alphaLeporis/velostat_development_kit/images/DSCF1139.jpg

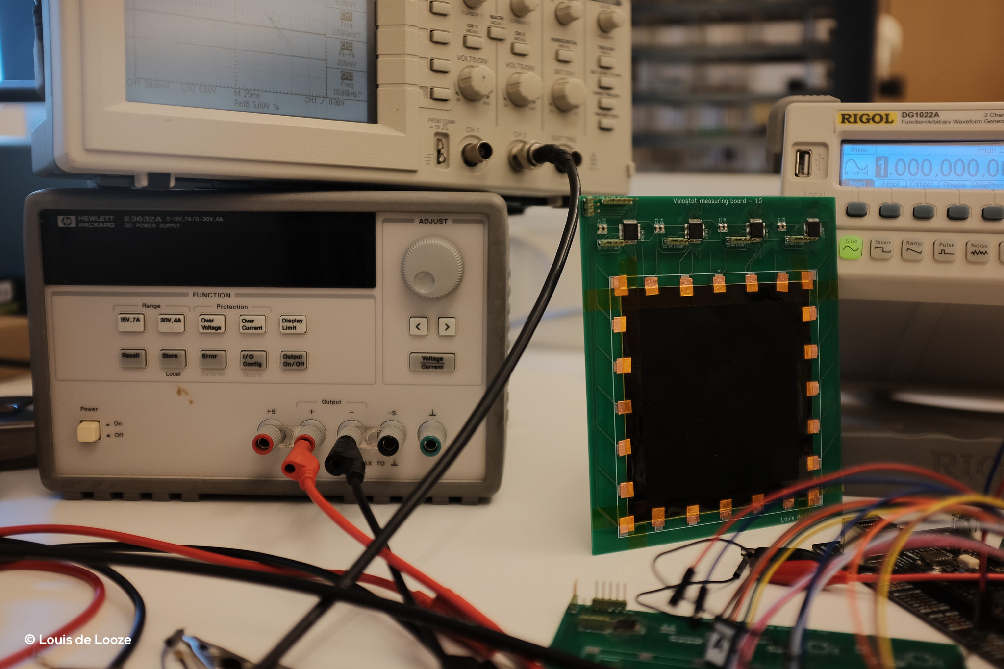
images/DSCF1139.jpg
