alphaLeporis/velostat_development_kit/images/DSCF1140.jpg

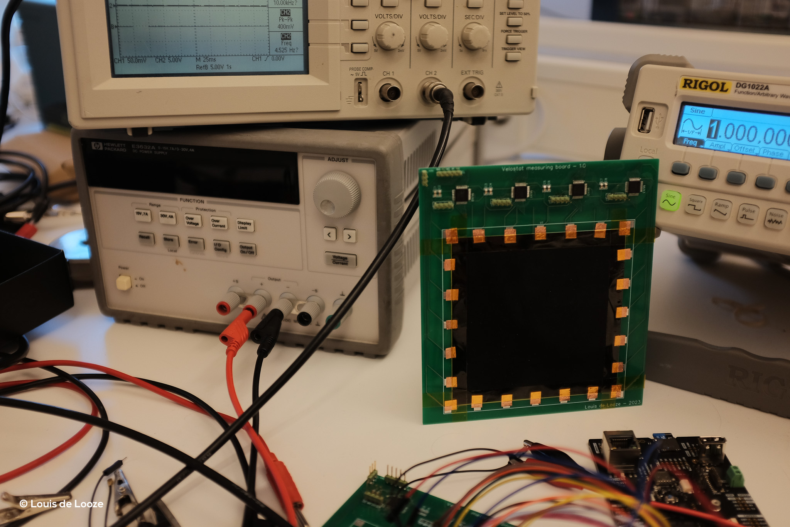
images/DSCF1140.jpg
