alphaLeporis/velostat_development_kit/images/DSCF1132.jpg

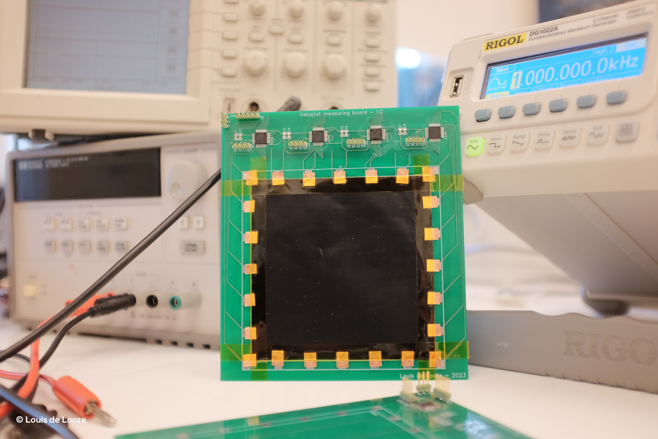
images/DSCF1132.jpg
