alphaLeporis/velostat_development_kit/images/DSCF1133.jpg

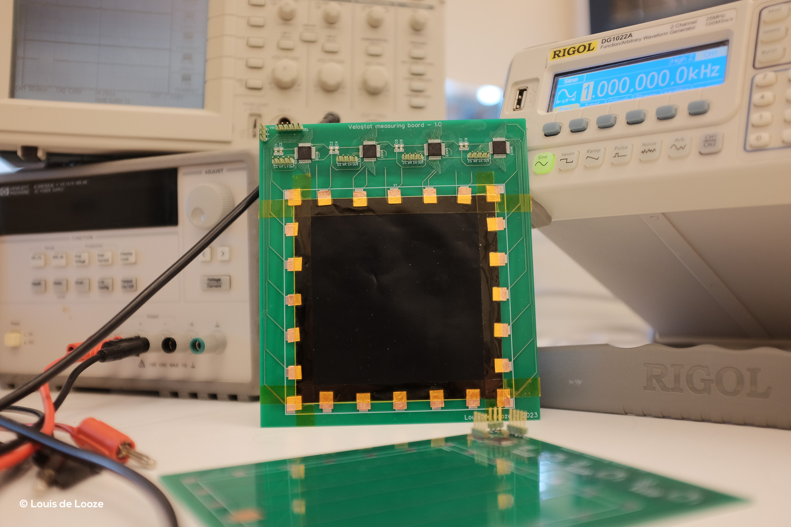
images/DSCF1133.jpg
