alphaLeporis/velostat_development_kit/images/DSCF1134.jpg

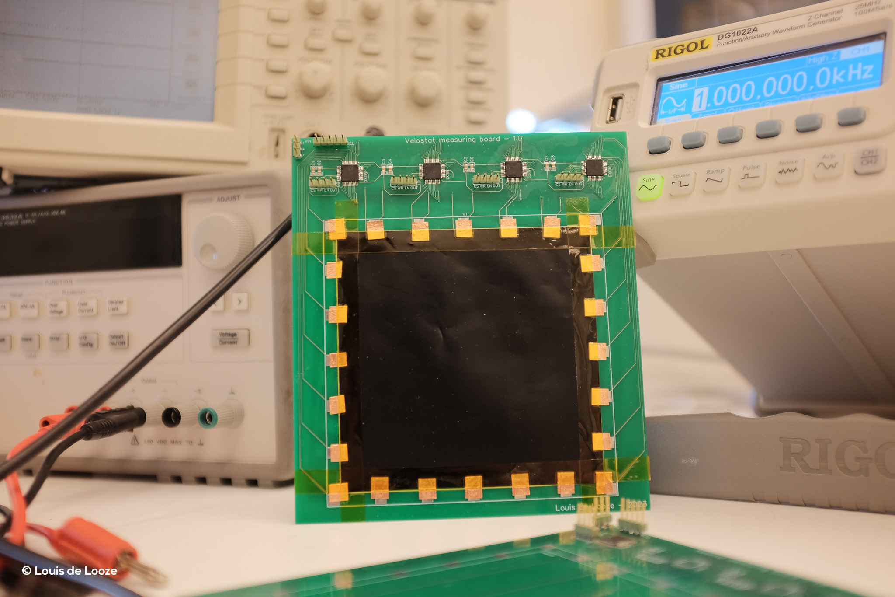
images/DSCF1134.jpg
