alphaLeporis/velostat_development_kit/images/DSCF1135.jpg

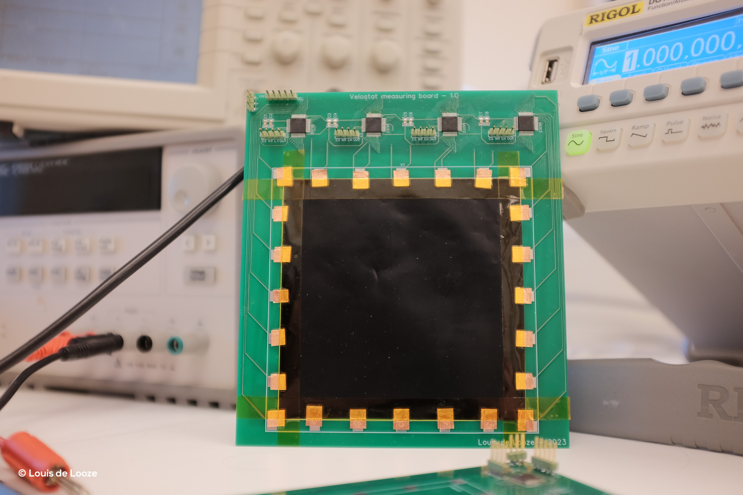
images/DSCF1135.jpg
