alphaLeporis/velostat_development_kit/images/DSCF1136.jpg

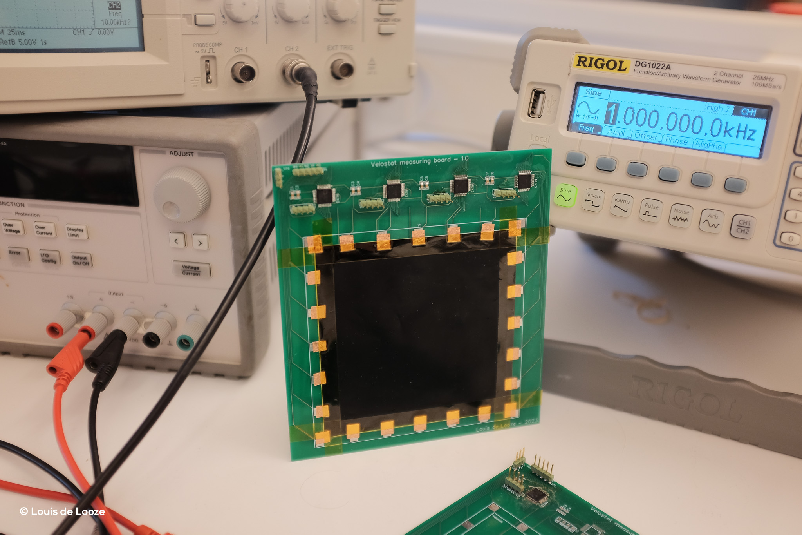
images/DSCF1136.jpg
