alphaLeporis/velostat_development_kit/images/DSCF1137.jpg

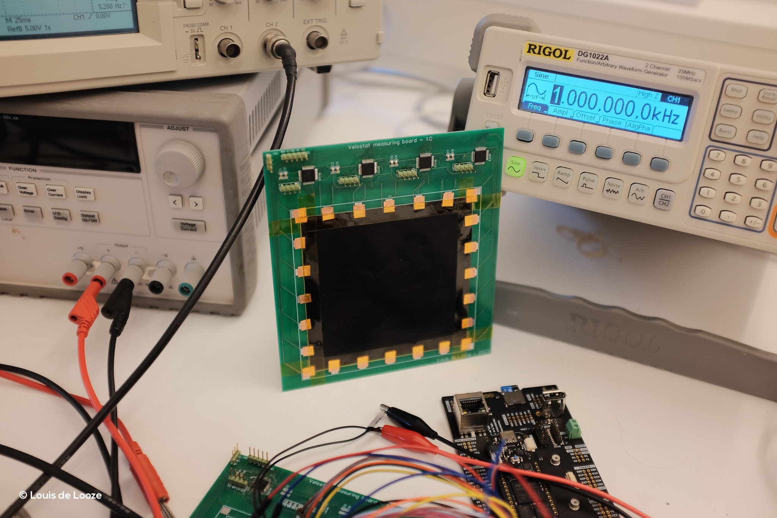
images/DSCF1137.jpg
