alphaLeporis/velostat_development_kit/images/DSCF1141.jpg

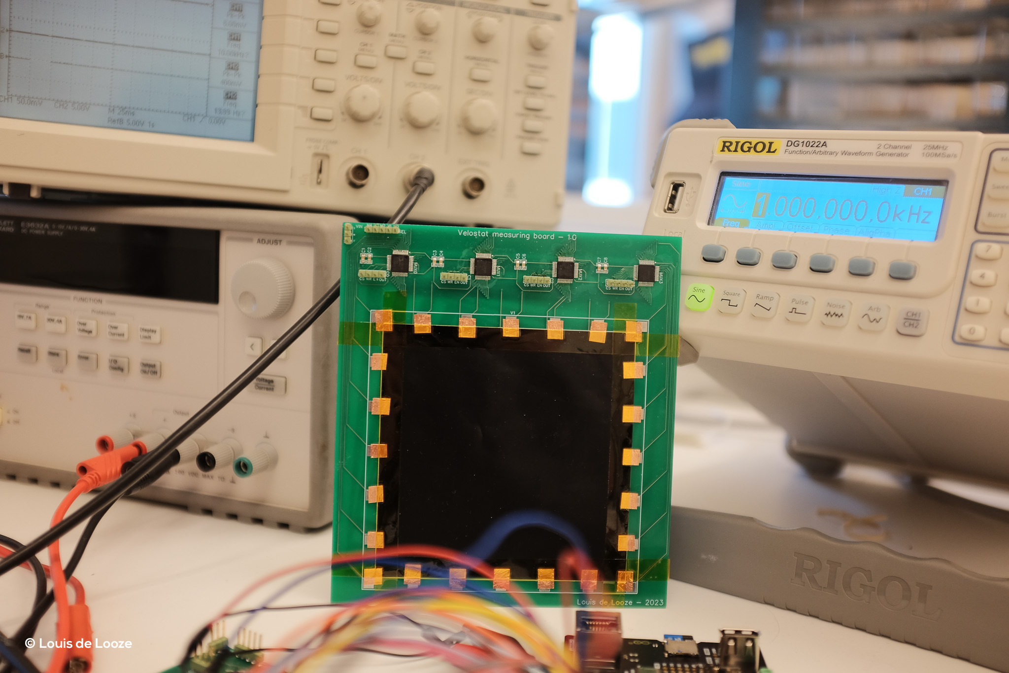
images/DSCF1141.jpg
