alphaLeporis/velostat_development_kit/images/DSCF1142.jpg

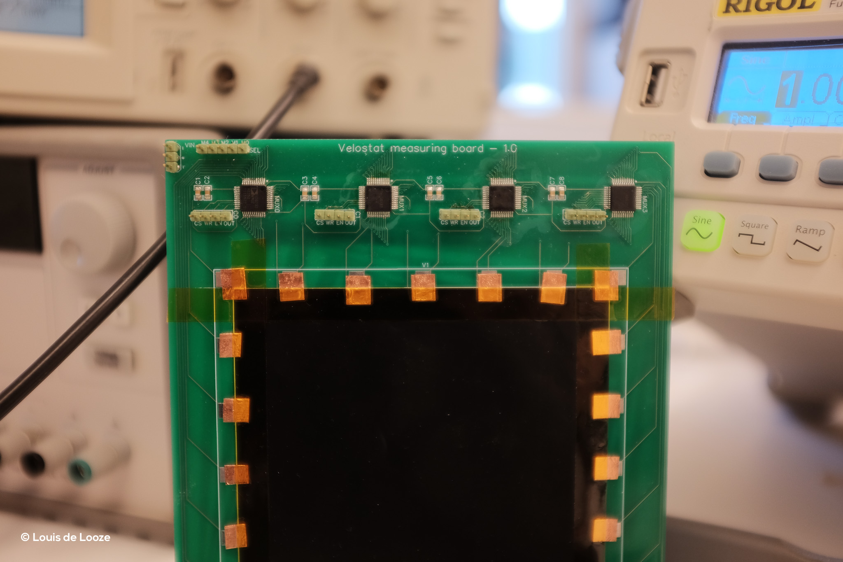
images/DSCF1142.jpg
