alphaLeporis/velostat_development_kit/images/DSCF1143.jpg

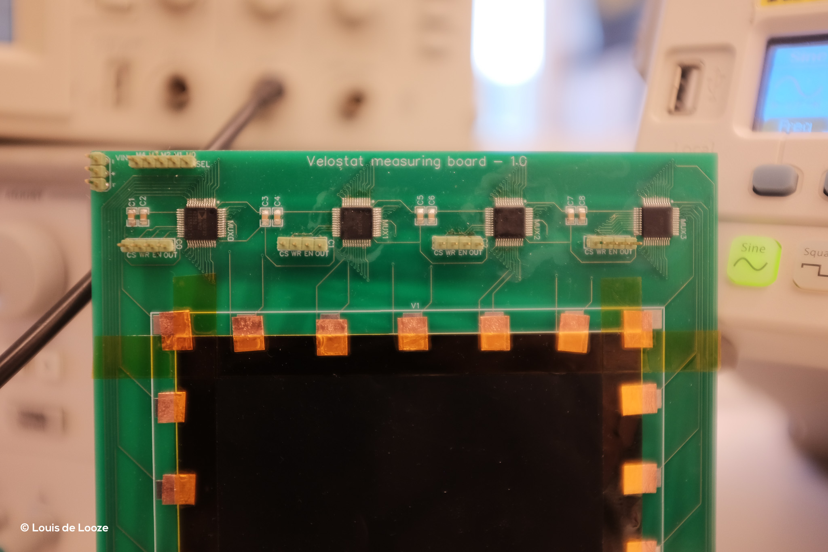
images/DSCF1143.jpg
