alphaLeporis/velostat_development_kit/images/DSCF1145.jpg

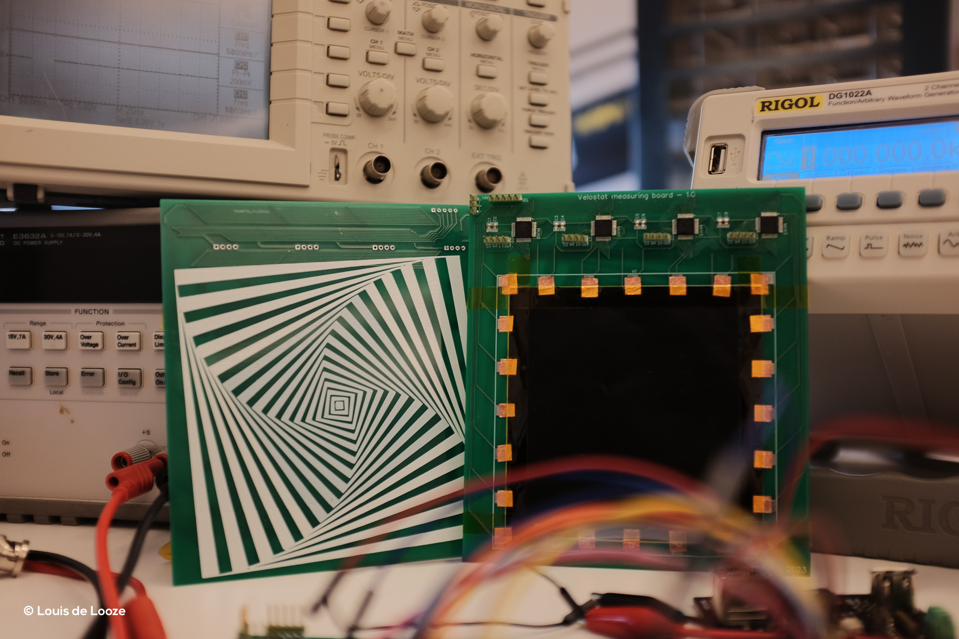
images/DSCF1145.jpg
