alphaLeporis/velostat_development_kit/images/DSCF1146.jpg

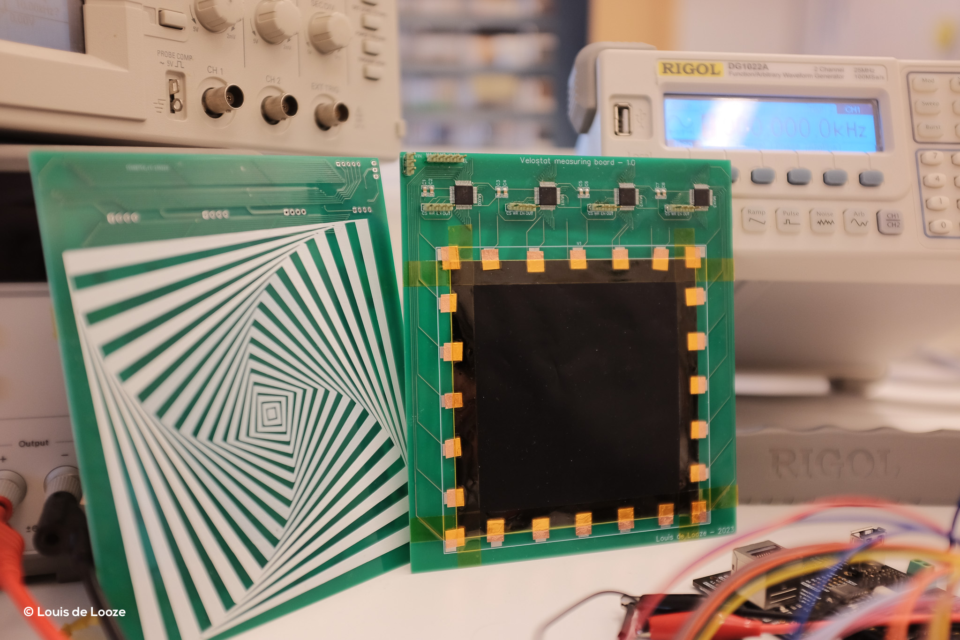
images/DSCF1146.jpg
