alphaLeporis/velostat_development_kit/images/DSCF1147.jpg

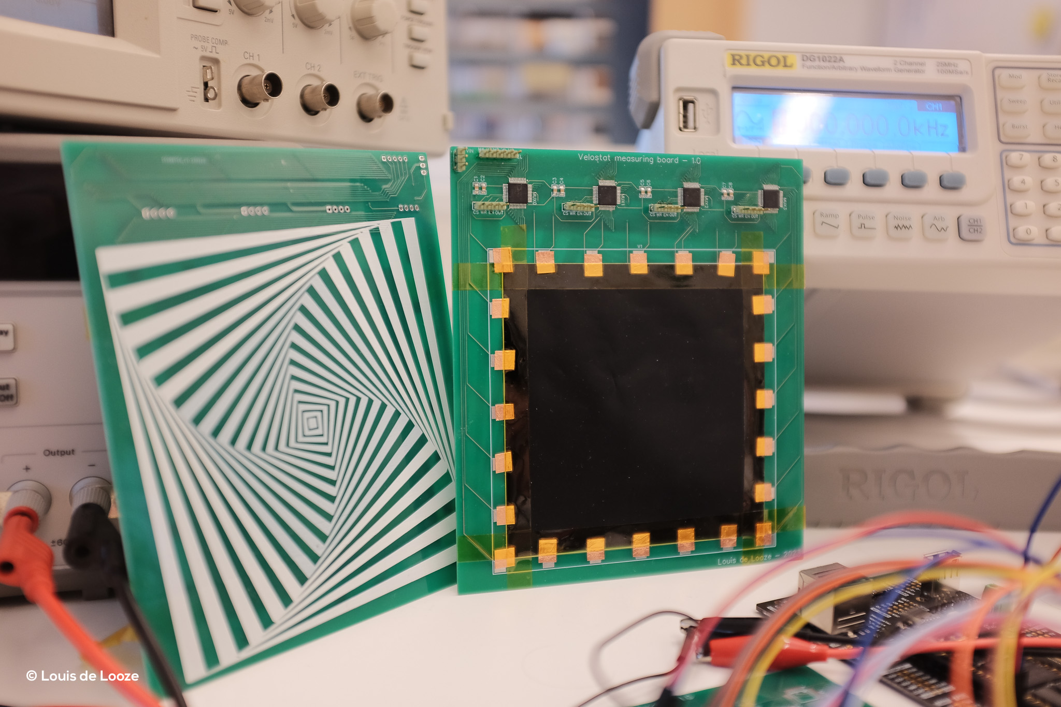
images/DSCF1147.jpg
