alphaLeporis/velostat_development_kit/images/DSCF1148.jpg

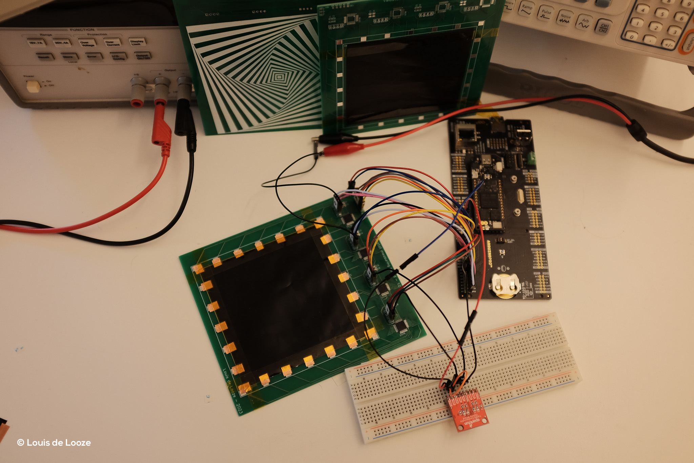
images/DSCF1148.jpg
