alphaLeporis/velostat_development_kit/images/DSCF1149.jpg

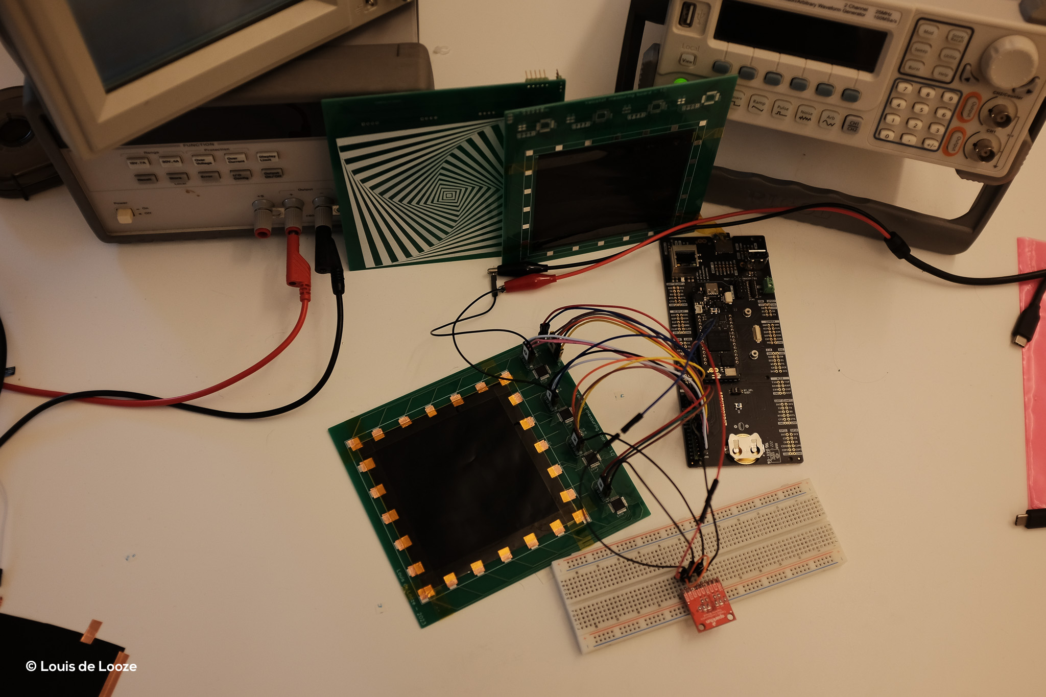
images/DSCF1149.jpg
