alphaLeporis/velostat_development_kit/images/DSCF1151.jpg

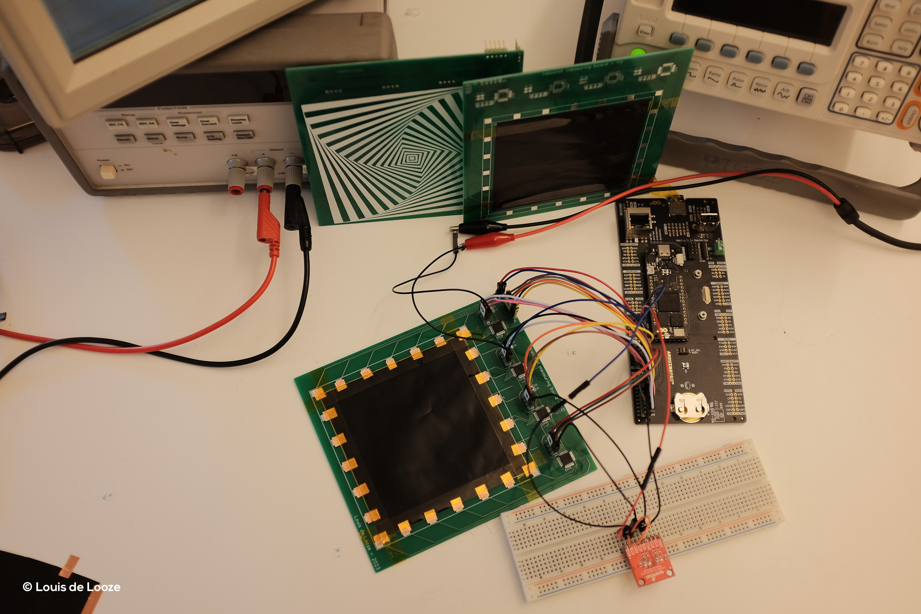
images/DSCF1151.jpg
