alphaLeporis/velostat_development_kit/images/DSCF1152.jpg

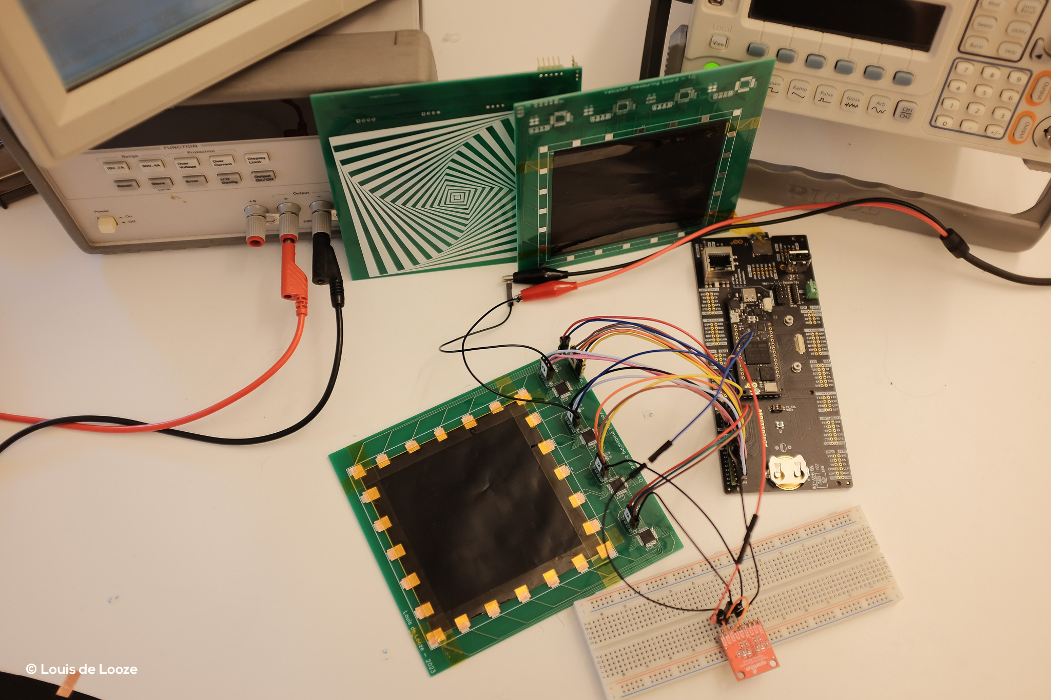
images/DSCF1152.jpg
