alphaLeporis/velostat_development_kit/images/DSCF1153.jpg

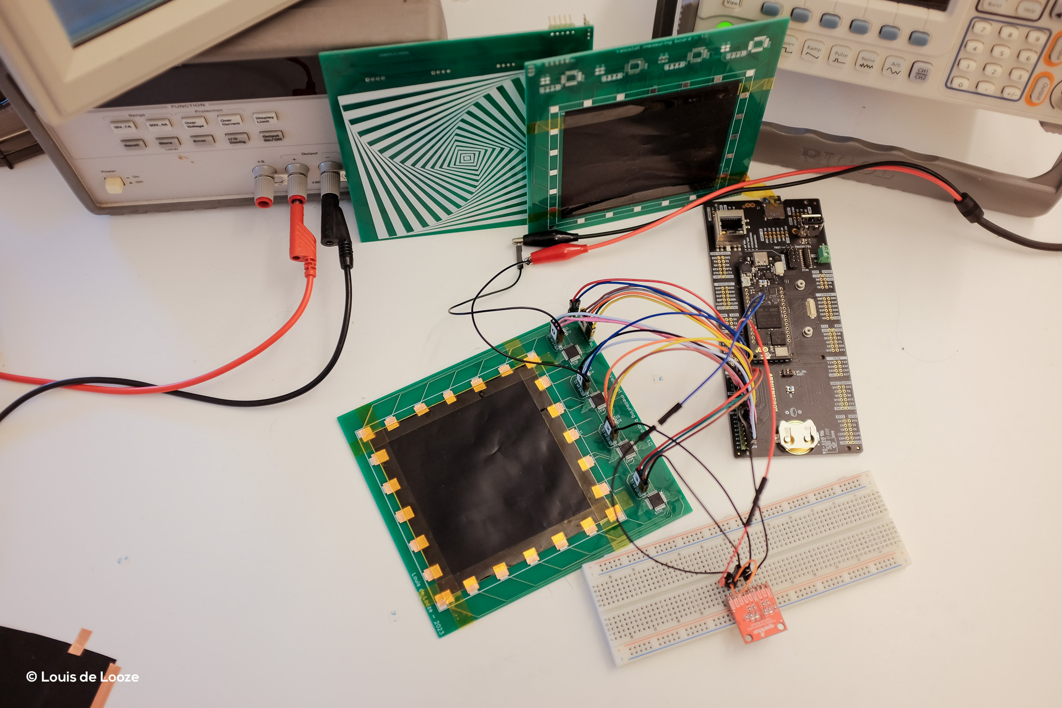
images/DSCF1153.jpg
