alphaLeporis/velostat_development_kit/images/DSCF1154.jpg

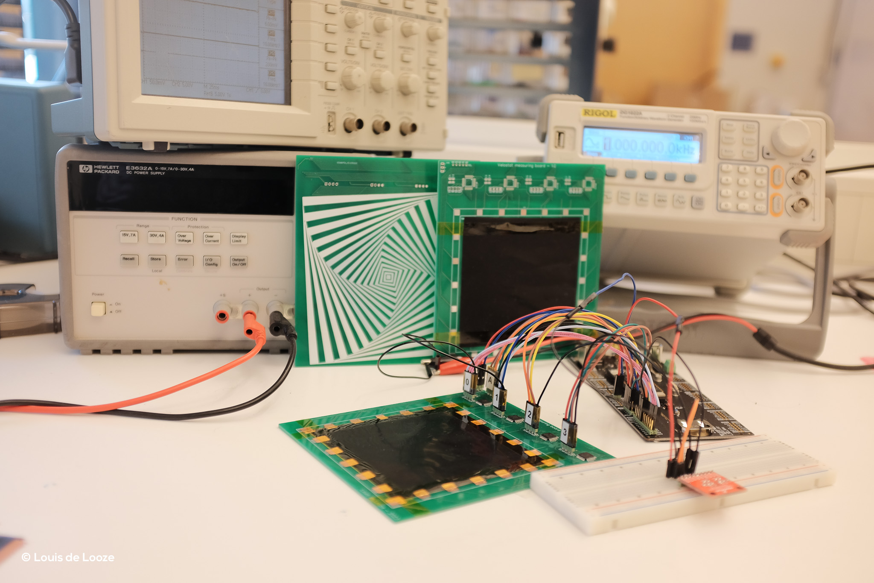
images/DSCF1154.jpg
