alphaLeporis/velostat_development_kit/images/DSCF1155.jpg

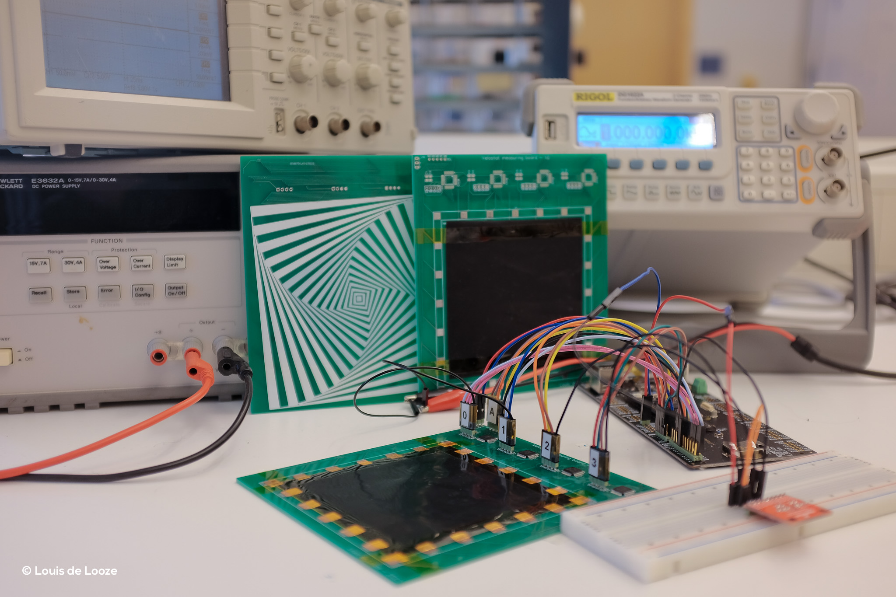
images/DSCF1155.jpg
