alphaLeporis/velostat_development_kit/images/DSCF1156.jpg

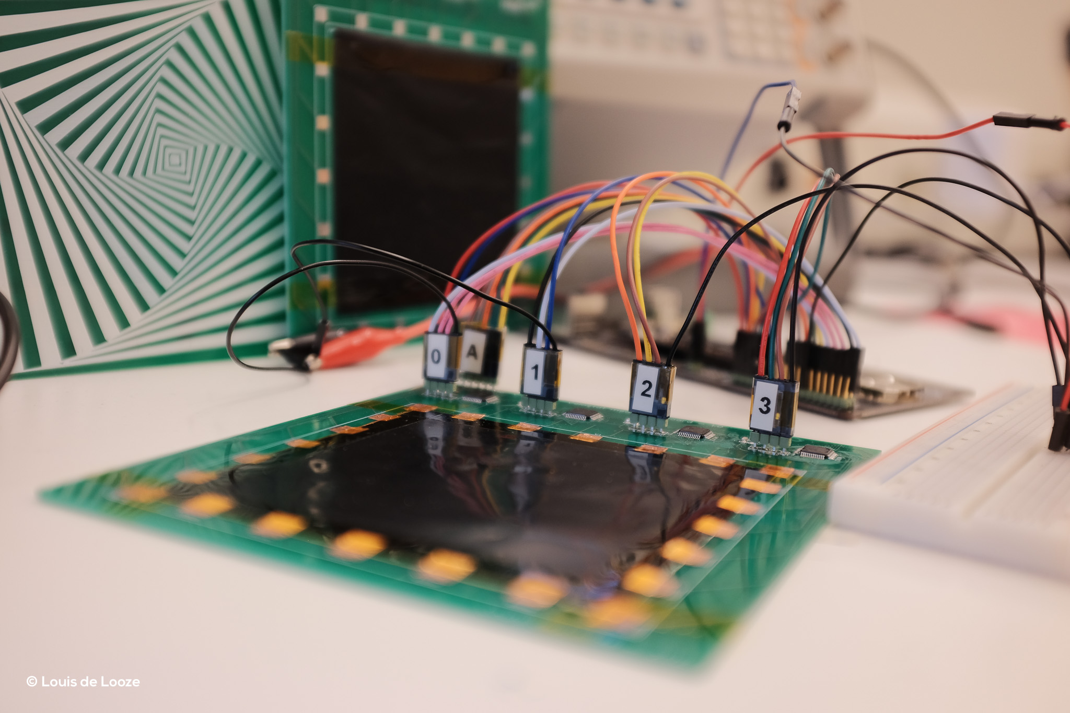
images/DSCF1156.jpg
