alphaLeporis/velostat_development_kit/images/DSCF1157.jpg

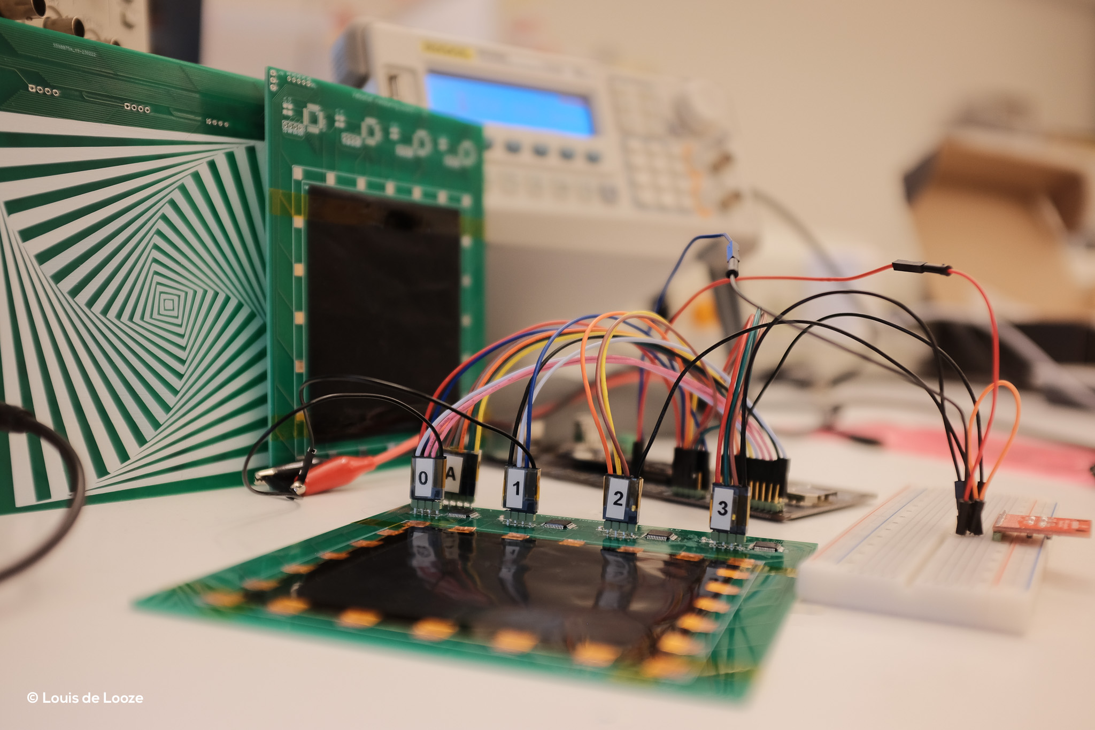
images/DSCF1157.jpg
