alphaLeporis/velostat_development_kit/images/DSCF1158.jpg

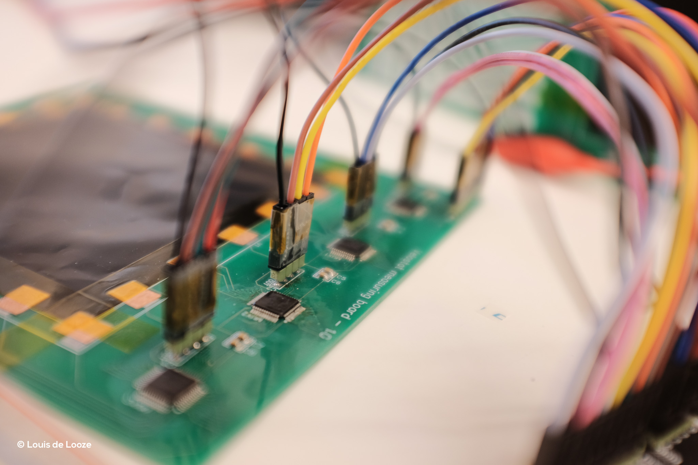
images/DSCF1158.jpg
