alphaLeporis/velostat_development_kit/images/DSCF1159.jpg

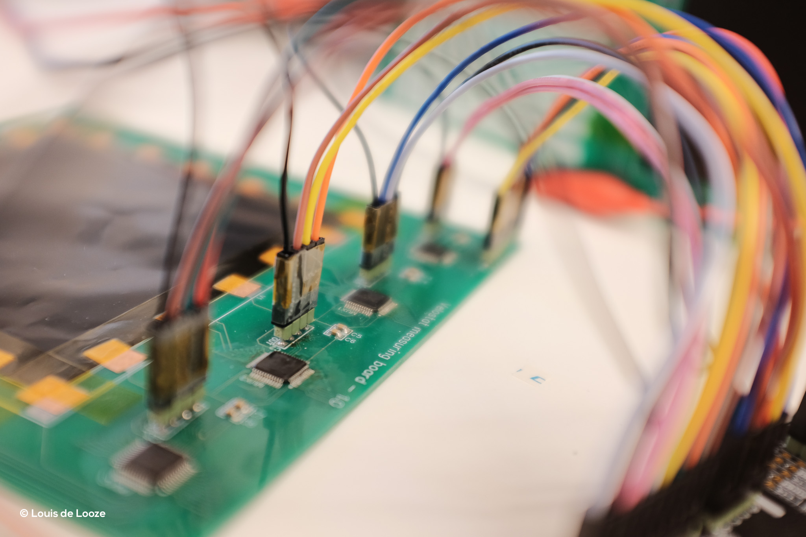
images/DSCF1159.jpg
