alphaLeporis/velostat_development_kit/images/DSCF1160.jpg

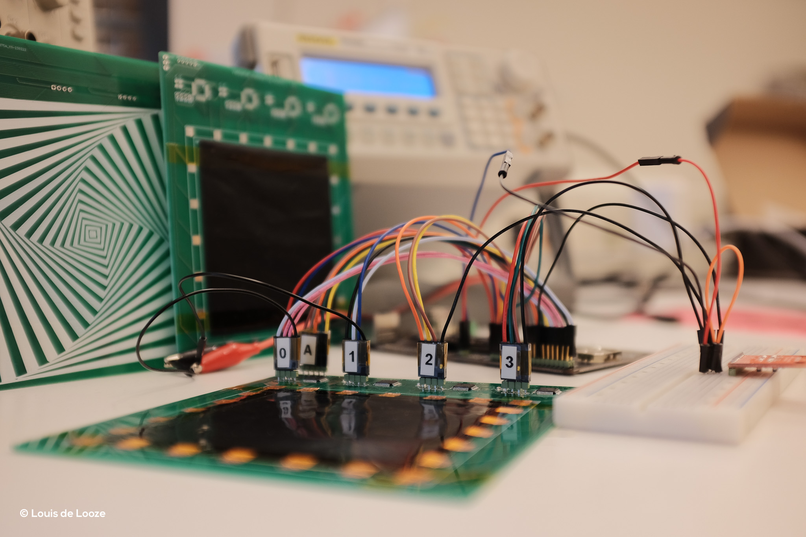
images/DSCF1160.jpg
