alphaLeporis/velostat_development_kit/images/DSCF1161.jpg

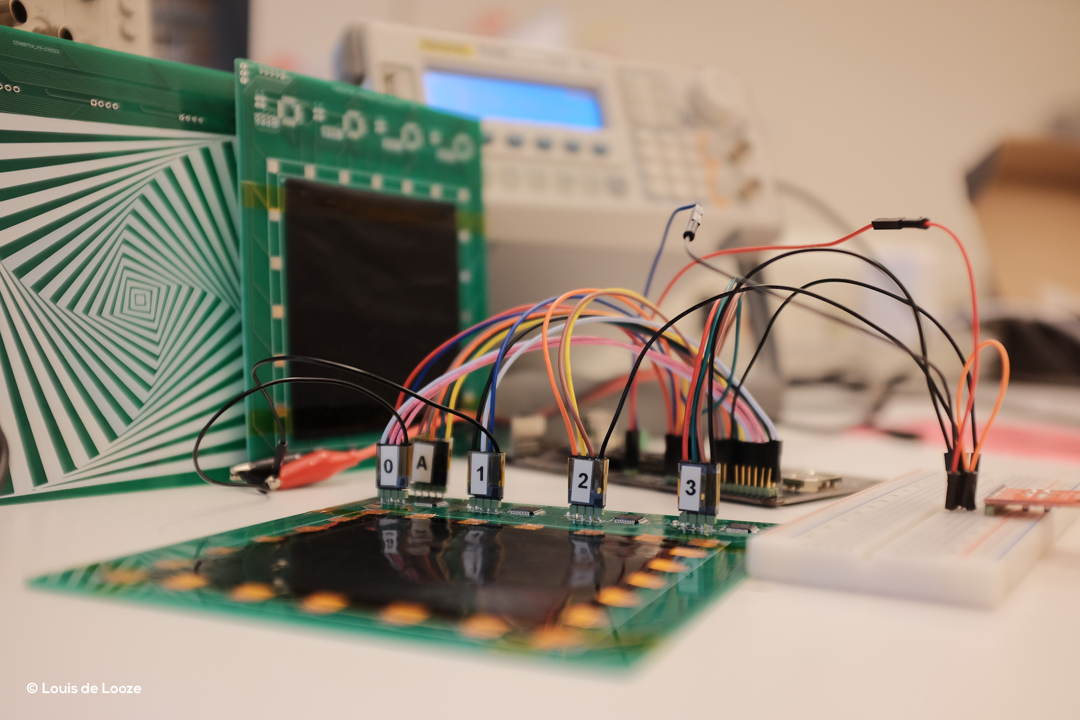
images/DSCF1161.jpg
