alphaLeporis/velostat_development_kit/images/DSCF1162.jpg

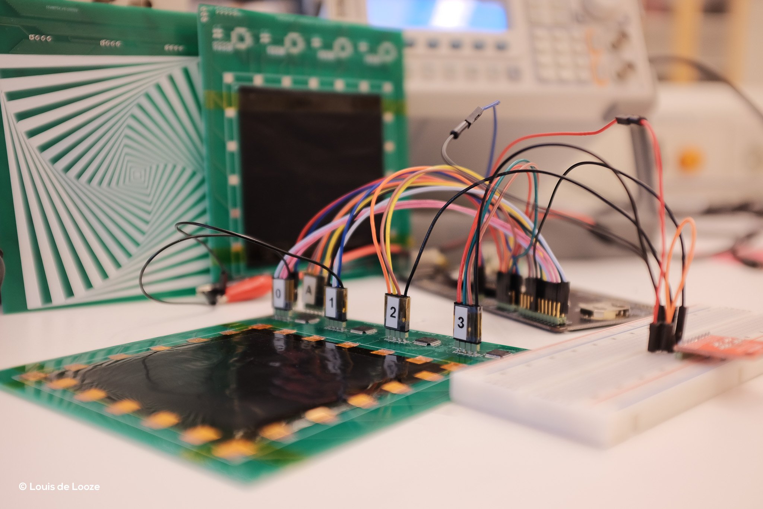
images/DSCF1162.jpg
