alphaLeporis/velostat_development_kit/images/DSCF1163.jpg

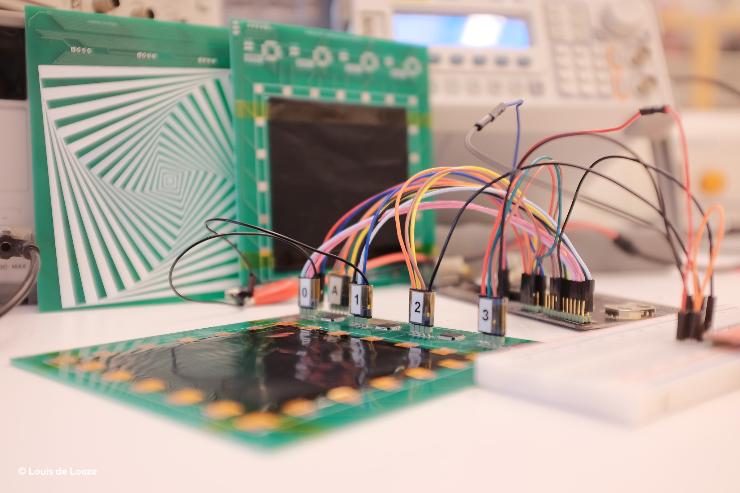
images/DSCF1163.jpg
