alphaLeporis/velostat_development_kit/images/DSCF1164.jpg

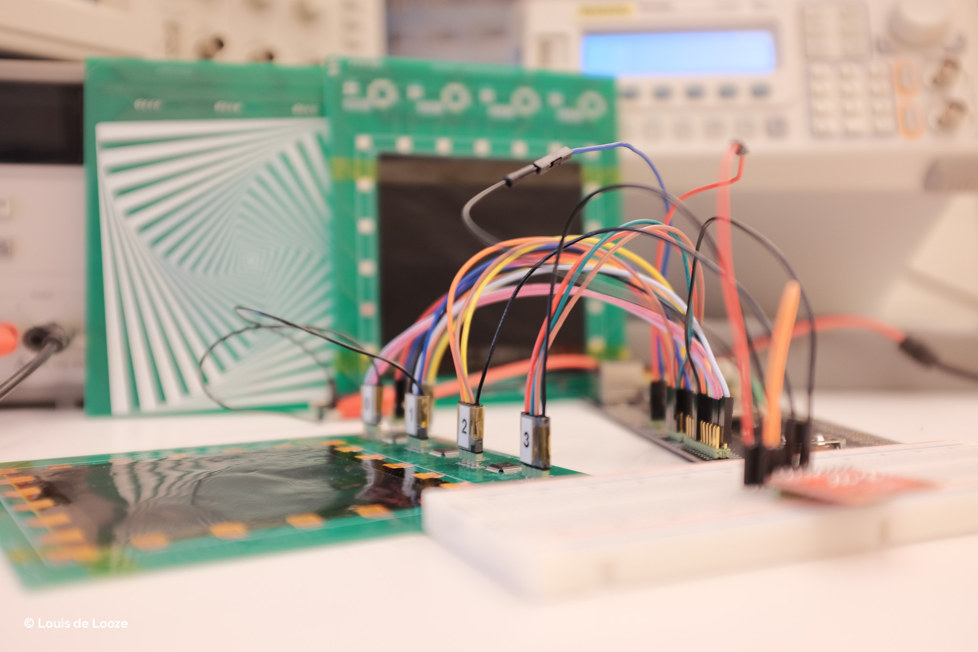
images/DSCF1164.jpg
