alphaLeporis/velostat_development_kit/images/DSCF1165.jpg

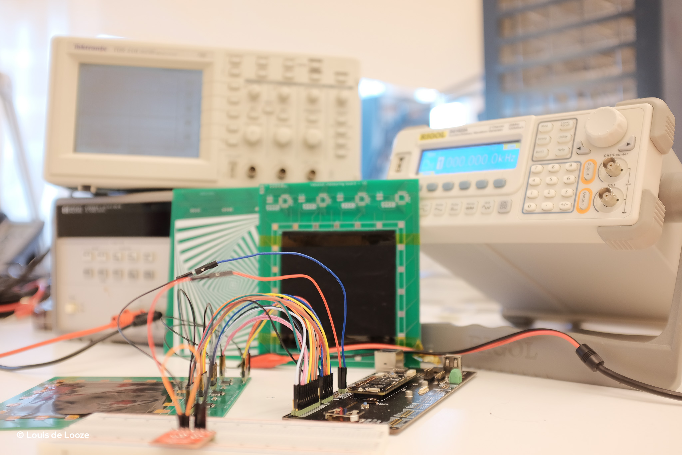
images/DSCF1165.jpg
