alphaLeporis/velostat_development_kit/images/DSCF1166.jpg

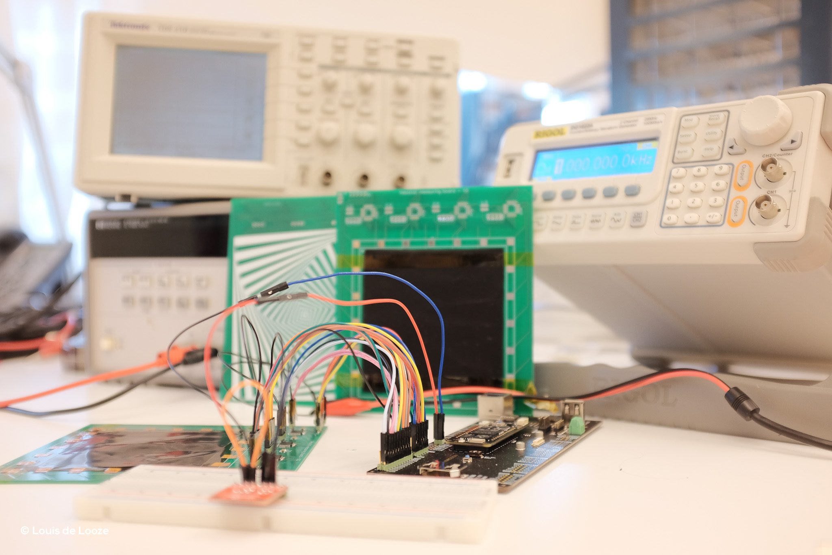
images/DSCF1166.jpg
