alphaLeporis/velostat_development_kit/images/DSCF1167.jpg

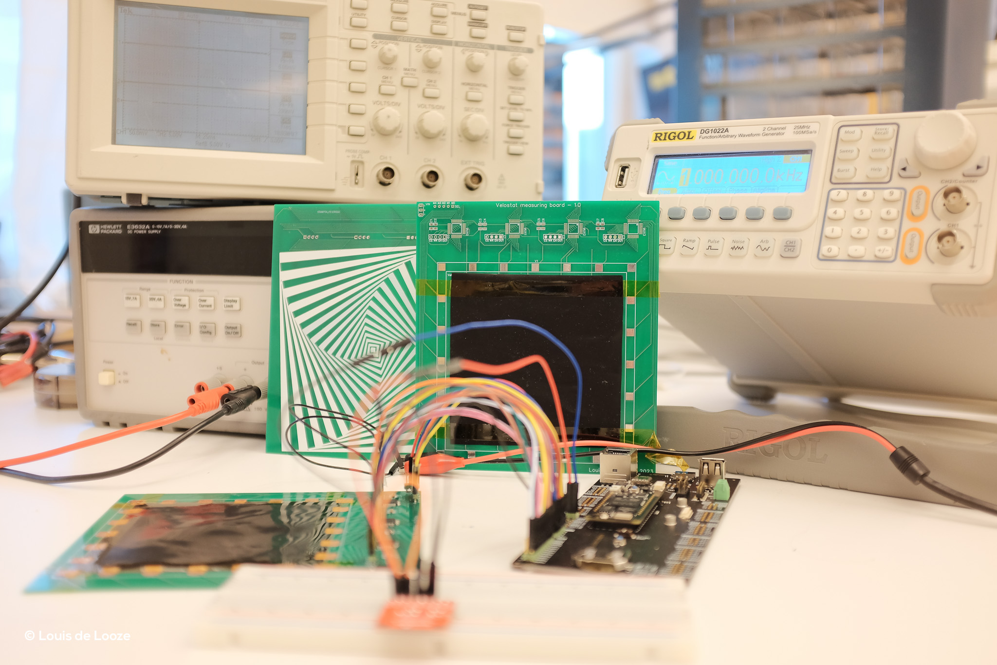
images/DSCF1167.jpg
