alphaLeporis/velostat_development_kit/images/DSCF1168.jpg

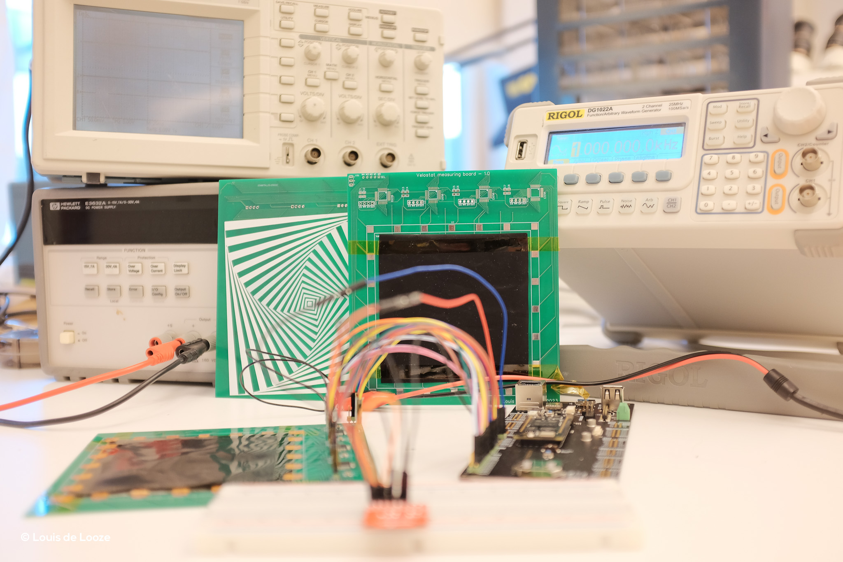
images/DSCF1168.jpg
