alphaLeporis/velostat_development_kit/images/DSCF1169.jpg

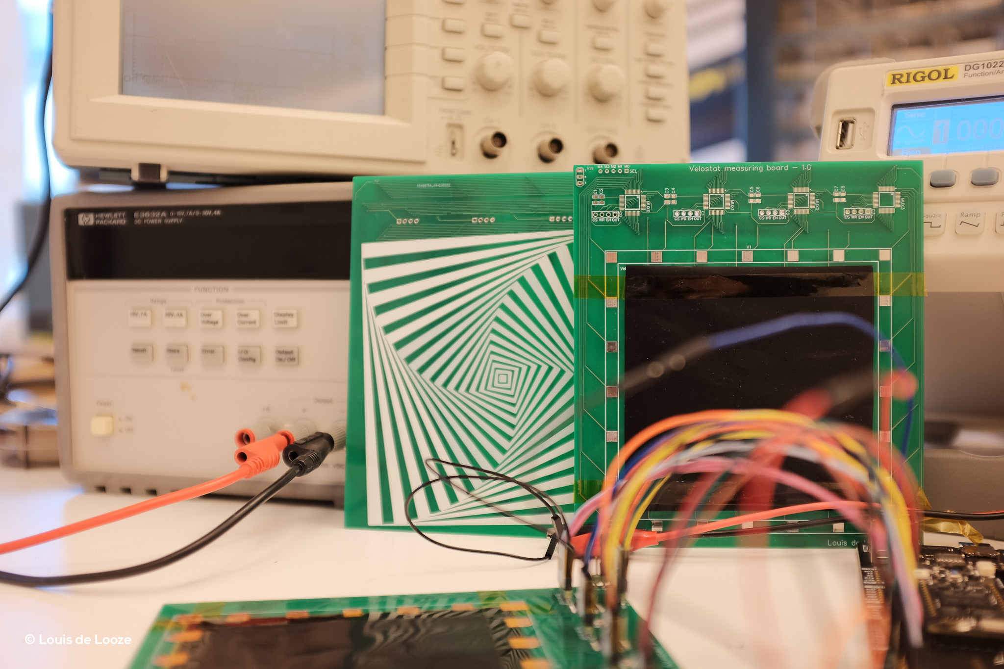
images/DSCF1169.jpg
