alphaLeporis/velostat_development_kit/images/DSCF1170.jpg

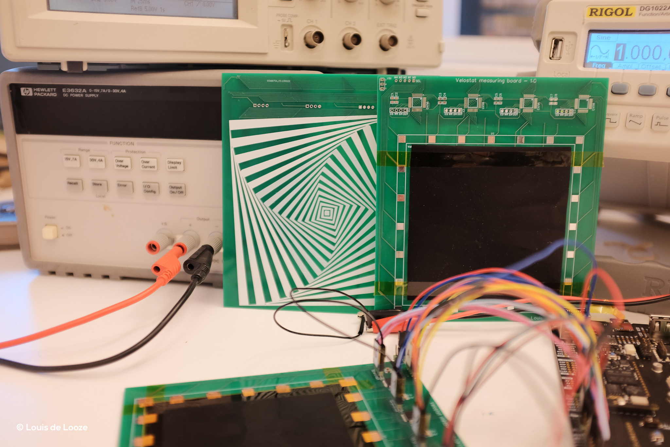
images/DSCF1170.jpg
