alphaLeporis/velostat_development_kit/web/src/assets/Vector.png

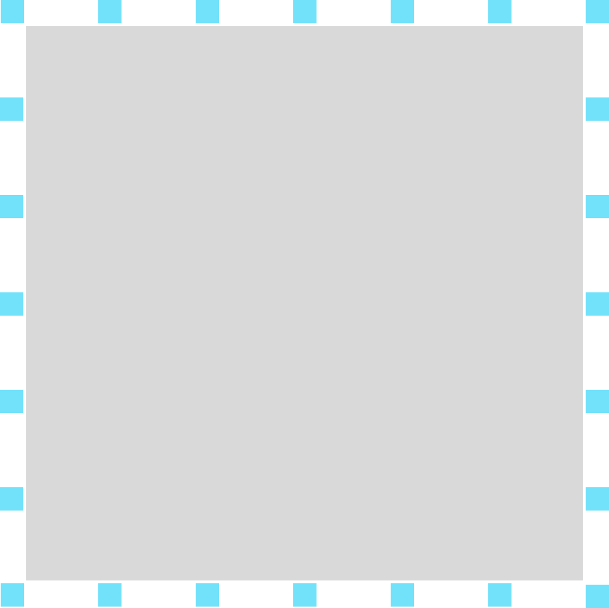
web/src/assets/Vector.png
