alphaLeporis/velostat_development_kit/hardware/pcb_design/BOM_vdk.csv

ID | Name | Designator | Footprint | Quantity | Manufacturer Part | Manufacturer | Supplier | Supplier Part | Price
1 | 0.1u | C1,C3,C5,C7 | 0805 | 4
2 | 1u | C2,C4,C6,C8 | 0805 | 4
3 | Mx | J1 | 5-PIN | 1
4 | ADG732BSUZ | MUX0,MUX1,MUX2,MUX3 | TQFP-48_L7.0-W7.0-P0.50-LS9.0-TL | 4 | ADG732BSUZ | ADI(亚德诺)/LINEAR(凌特) | LCSC | C579103 | 8.015
5 | Velostat Pad | P1 | VELOSTAT PAD 26MM | 1
6 | M0_CTRL | U1 | 4 PIN 16CH MUX CONTROL | 1 | New SchematicLib
7 | M1_CTRL | U2 | 4 PIN 16CH MUX CONTROL | 1 | New SchematicLib
8 | M2_CTRL | U3 | 4 PIN 16CH MUX CONTROL | 1 | New SchematicLib
9 | M3_CTRL | U4 | 4 PIN 16CH MUX CONTROL | 1 | New SchematicLib
10 | powerpin | U6 | SERVO-HEADER-3PIN | 1
