alphaLeporis/velostat_development_kit/(list of files, drawings)

Other design files:
hardware/pcb_design/PCB_vdk.json
hardware/pcb_design/SCH_vdk.json
